w-dee/dotmatrix_64x48_hw_3.0/dotmatrix_64x48.kicad_pcb

## KiCad design dotmatrix_64x48.kicad_pcb (2016-11-04)

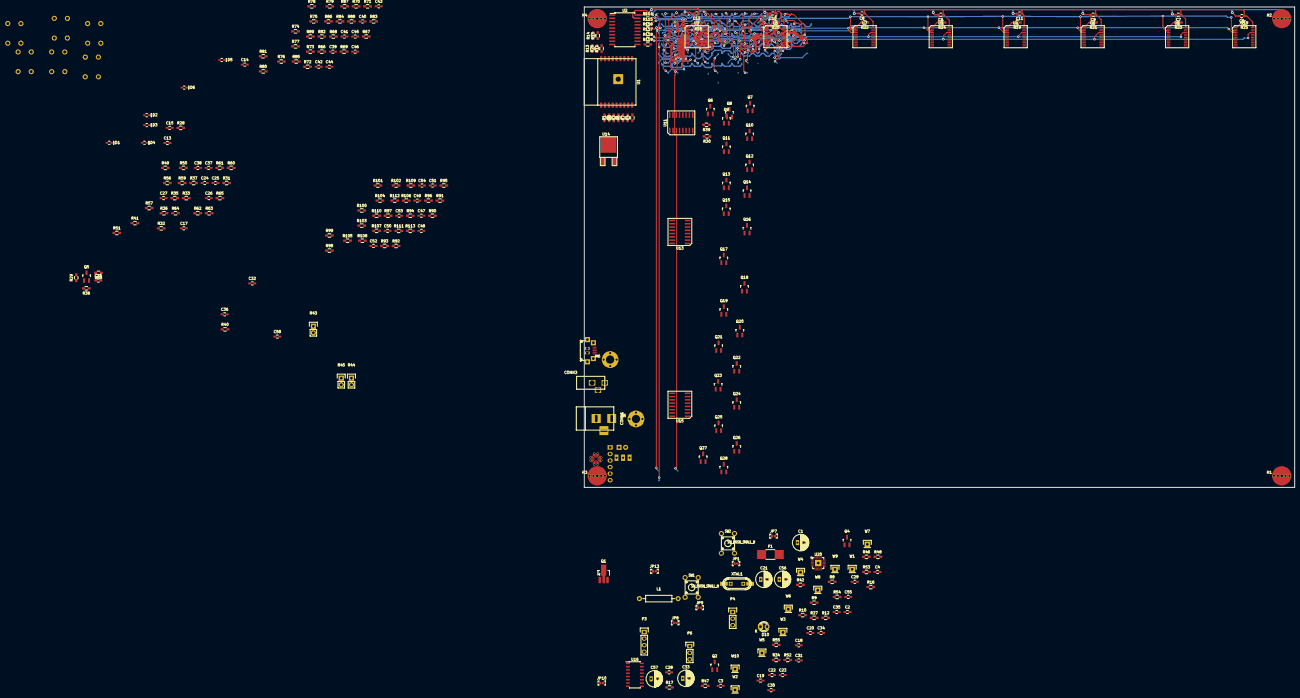
[picture p1: board dotmatrix_64x48.kicad_pcb from above]

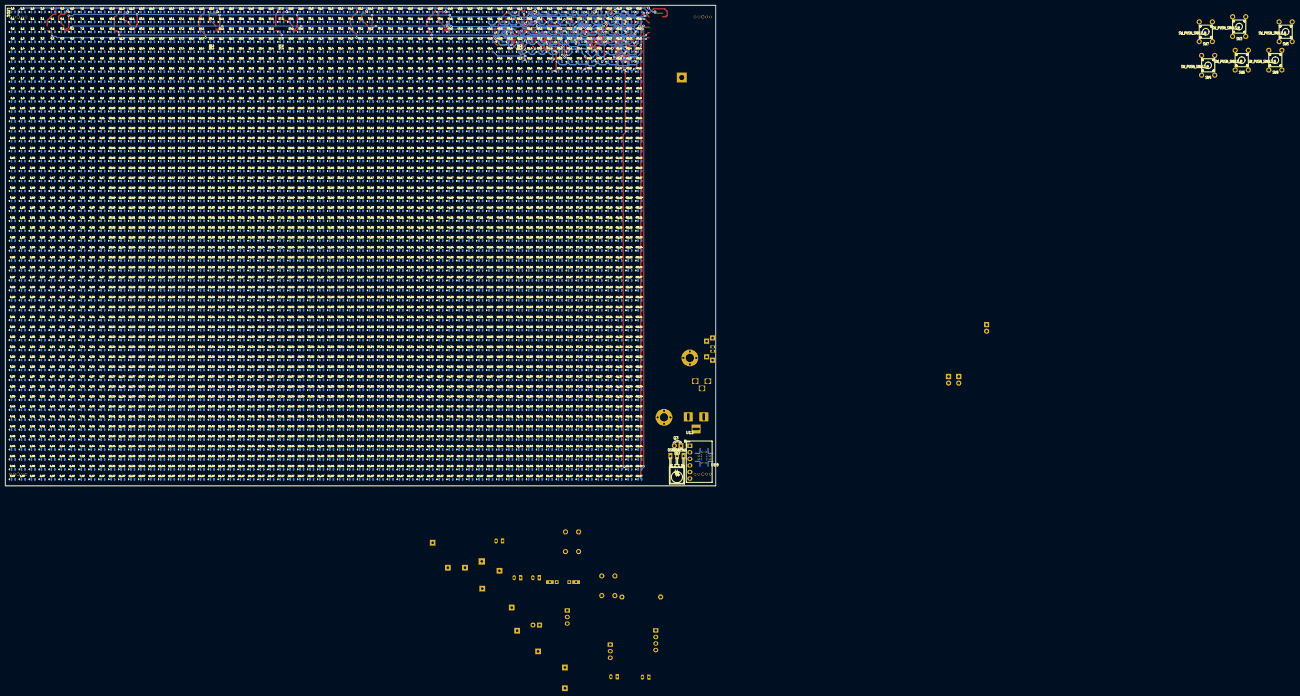
[picture p2: board dotmatrix_64x48.kicad_pcb from below]

Board: 2 copper layers, 275.0 x 186.0 mm, 271 parts (11 on the bottom side), 292 nets.

Parts:
C1, C21, C33, C56, C57: 100u; C_Radial_D6.3_L11.2_P2.5_hand_soldering
C2, C4, C5, C6, C7, C8, C9, C10, C11, C12, C13, C14, C15, C16, C17, C18, C19, C20, C22, C23, C24, C25, C26, C27, C28, C30, C32, C34, C35, C36, C37, C38, C39, C40, C41, C42, C43, C44, C45, C46, C47, C48, C49, C50, C51, C52, C53, C54, C55, C58: 1u; C_0603_HandSoldering
C3: 220p; C_0603_HandSoldering
C29, C31: 22p; C_0603_HandSoldering
CONN1: BARREL_JACK
CONN2: USB_OTG; ZX62R-B-5P
CONN3: BARREL_JACK; DC-JACK-3.5mm
D1, D2, D3, D4, D5, D6: D_Schottky_Small; SOD-523-mod
D10: Led_Small; LED-3MM
F1: FUSE; R_1812_HandSoldering
H1, H2, H3, H4: TEST_1P; MountingHole_stud-M3
H5, H6: TEST_1P; MountingHole_3.2mm_M3
JP1, JP7, JP8, JP9, JP10, JP13: Jumper_NC_Small; SolderJumper
L1: 2.2uH; Resistor_Horizontal_RM15mm
LED1: LED64x48; LED1608_Handsoldering_64x48
P3: CONN_01X04; Pin_Header_Straight_1x04
P4, P6: CONN_01X03; Pin_Header_Straight_1x03
Q1: Q_NPN_BCE RN5006; SOT89-3_Housing_Handsoldering
Q2, Q4: Q_NPN_BEC; SOT-23_Handsoldering
Q3: NJL7302L-F3; LED-3MM
Q5, Q6, Q7, Q8, Q9, Q10, Q11, Q12, Q13, Q14, Q15, Q16, Q17, Q18, Q19, Q20, Q21, Q22, Q23, Q24, Q25, Q26, Q27, Q28: AO3401; SOT-23_Handsoldering
R1, R2, R3, R4, R6, R7, R13, R14, R15, R17, R26, R46, R52, R114, R115, R116, R117, R118, R119: 120R; R_0603_HandSoldering
R5, R11, R18, R28, R34, R53, R54, R55: 10k; R_0603_HandSoldering
R8, R16, R27, R58, R59, R60, R61, R62, R63, R64, R65, R82, R83, R84, R85, R86, R87, R88, R89, R106, R107, R108, R109, R110, R111, R112, R113: 4.7k; R_0603_HandSoldering
R9, R10, R40: 22k; R_0603_HandSoldering
R12, R48: 1k; R_0603_HandSoldering
R19, R20, R21, R22, R23, R24, R25: R; R_0603_HandSoldering
R29, R30, R31, R32, R33, R35, R36, R37, R66, R67, R68, R69, R70, R71, R72, R73, R90, R91, R92, R93, R94, R95, R96, R97: 10R; R_0603_HandSoldering
R38, R39, R41, R49, R50, R51, R56, R57, R74, R75, R76, R77, R78, R79, R80, R81, R98, R99, R100, R101, R102, R103, R104, R105: 4.7k DNI; R_0603_HandSoldering
R42: 10k DNI; R_0603_HandSoldering
R43, R44, R45: 10k; Pin_Header_Straight_1x02
R47: 120R DNI; R_0603_HandSoldering
SW1, SW2, SW3, SW4, SW5, SW6, SW7, SW8: SW_PUSH_SMALL_H; TACT-SW-4P
U1: WROOM-02
U2: 74VHC541; SOIC-20W_7.5x12.8mm_Pitch1.27mm_W
U3, U4, U5, U6, U7, U8, U9, U10: LED1642GW; SOIC-24-0.65mm-w8.0mm
U11, U13, U15: 74HCT595; SOIC-16-1.27mm
U12: AE-BME280
U14: NJU7223; TO-252-2Lead
U16: CH340G; SOIC-16_3.9x9.9mm_Pitch1.27mm
U17: OSRB38C9AA; IRM2161_LAY
U18: BME280; BME280-handsoldering
U20: CP2104; QFN-24-1EP_4x4mm_Pitch0.5mm-handsoldering
W1, W2, W3, W4, W5, W6, W7, W8, W9, W10: TEST_1P; Pin_Header_Straight_1x01
XTAL1: 12MHz; Crystal_HC49-U_Vertical_SMD_Universal

Connections:
/row_driver/SEL1: D1.1, R90.2, U15.7
/row_driver/SEL2: D2.1, R91.2, U15.6
/row_driver/SEL3: D3.1, R92.2, U15.5
/row_driver/SEL4: D4.1, R93.2, U15.4
/row_driver/SEL5: D5.1, R94.2, U15.3
/row_driver/SEL6: D6.1, R95.2, U15.2
/row_driver/f_r0/IN0: R29.2, U11.7
/row_driver/f_r0/IN1: R30.2, U11.6
/row_driver/f_r0/IN2: R31.2, U11.5
/row_driver/f_r0/IN3: R32.2, U11.4
/row_driver/f_r0/IN4: R33.2, U11.3
/row_driver/f_r0/IN5: R35.2, U11.2
/row_driver/f_r0/IN6: R36.2, U11.1
/row_driver/f_r0/IN7: R37.2, U11.15
/row_driver/f_r8/IN0: R66.2, U13.7
/row_driver/f_r8/IN1: R67.2, U13.6
/row_driver/f_r8/IN2: R68.2, U13.5
/row_driver/f_r8/IN3: R69.2, U13.4
/row_driver/f_r8/IN4: R70.2, U13.3
/row_driver/f_r8/IN5: R71.2, U13.2
/row_driver/f_r8/IN6: R72.2, U13.1
/row_driver/f_r8/IN7: R73.2, U13.15
/row_driver/f_r16/IN6: R96.2, U15.1
/row_driver/f_r16/IN7: R97.2, U15.15
BUTTONSENSE: R13.2, R28.2, SW3.2, SW4.2, SW5.2, SW6.2, SW7.2, SW8.2, W9.1
COLCLK: R115.2, U3.3, U4.3, U5.3, U6.3, U7.3, U8.3, U9.3, U10.3, U11.11, U13.11, U15.11, W2.1
COLLATCH: R116.2, U3.4, U4.4, U5.4, U6.4, U7.4, U8.4, U9.4, U10.4, W3.1
COLPWCLK0: R117.2, U3.21, U4.21, U7.21, U8.21, W5.1
COLPWCLK1: R118.2, U5.21, U6.21, U9.21, U10.21, W10.1
COLSER: R114.2, U3.2, W1.1
COLSEROUT: U10.22, U15.14, W4.1
DC_IN: CONN1.1, F1.1, JP7.1
DTR: Q4.2, R54.2, U16.13, U20.23
ESPVDD: C18.1, C19.1, C20.1, C32.1, C33.1, C34.1, C35.1, C36.1, C55.1, C56.1, C57.1, JP8.1, L1.2, R5.2, R8.1, R9.1, R10.1, R11.2, R27.1, R40.1, R45.2, U1.1, U12.1, U17.3, U18.2, U18.6, U18.8
E_AIN: C58.1, Q3.2, R26.2, R43.1
E_COLCLK: R1.1, U2.3
E_COLLATCH: R2.1, U2.4
E_COLSER: R3.1, U2.2
E_HC595LATCH: R6.1, U2.9
E_PWCLK: R14.2, U2.6, U2.7
E_RXD: R14.1, R16.1, U1.11
E_SCL: R4.2, R9.2, R52.1, U1.8
E_SDA: R46.1, U1.14
E_TXD: R17.1, U1.12
GND: C1.2, C4.2, C5.2, C6.2, C7.2, C8.2, C9.2, C10.2, C11.2, C12.2, C13.2, C14.2, C15.2, C16.2, C17.2, C18.2, C19.2, C20.2, C21.2, C22.2, C23.2, C24.2, C25.2, C26.2, C27.2, C28.2, C29.2, C30.2, C31.2, C32.2, C33.2, C34.2, C35.2, C36.2, C37.2, C38.2, C39.2, C40.2, C41.2, C42.2, C43.2, C44.2, C45.2, C46.2, C47.2, C48.2, C49.2, C50.2, C51.2, C52.2, C53.2, C54.2, C55.2, C56.2, C57.2, C58.2, CONN1.2, CONN1.3, CONN2.5, CONN2.6, H1.1, H2.1, H3.1, H4.1, H5.1, H6.1, P3.2, P4.1, P6.1, P6.3, Q1.3, Q3.1, R18.2, R19.2, R20.2, R21.2, R22.2, R23.2, R24.2, R25.2, R34.2, R42.1, R47.1, R47.2, R48.1, R58.1, R59.1, R60.1, R61.1, R62.1, R63.1, R64.1, R65.1, R82.1, R83.1, R84.1, R85.1, R86.1, R87.1, R88.1, R89.1, R106.1, R107.1, R108.1, R109.1, R110.1, R111.1, R112.1, R113.1, SW1.2, SW2.2, U1.9, U1.13, U1.18, U2.1, U2.5, U2.8, U2.10, U2.19, U3.1, U4.1, U5.1, U6.1, U7.1, U8.1, U9.1, U10.1, U11.8, U11.13, U12.2, U13.8, U13.13, U14.3, U15.8, U15.13, U16.1, U17.2, U18.1, U18.5, U18.7, U20.2, U20.25
GPIO0_BTN: Q4.3, R4.1, SW1.1
HC595LATCH: R119.2, U11.12, U13.12, U15.12, W7.1
HC595RESET: U11.10, U13.10, U15.10, W6.1
HC595SEROUT: U11.9, W8.1
IR_IN: R15.2, R40.2, U17.1
IR_OUT: C2.2, D10.2, R7.1
LEDLOGICVDD: C5.1, C6.1, C7.1, C8.1, C9.1, C10.1, C11.1, C12.1, JP13.2, L1.1, P6.2, R28.1, U2.20, U3.24, U4.24, U5.24, U6.24, U7.24, U8.24, U9.24, U10.24
LEDVDD: C13.1, C14.1, C15.1, C16.1, C17.1, C24.1, C25.1, C26.1, C27.1, C37.1, C38.1, C39.1, C40.1, C41.1, C42.1, C43.1, C44.1, C45.1, C46.1, C47.1, C48.1, C49.1, C50.1, C51.1, C52.1, C53.1, C54.1, JP1.2, Q5.2, Q6.2, Q7.2, Q8.2, Q9.2, Q10.2, Q11.2, Q12.2, Q13.2, Q14.2, Q15.2, Q16.2, Q17.2, Q18.2, Q19.2, Q20.2, Q21.2, Q22.2, Q23.2, Q24.2, Q25.2, Q26.2, Q27.2, Q28.2, R38.1, R39.1, R41.1, R49.1, R50.1, R51.1, R56.1, R57.1, R74.1, R75.1, R76.1, R77.1, R78.1, R79.1, R80.1, R81.1, R98.1, R99.1, R100.1, R101.1, R102.1, R103.1, R104.1, R105.1, U11.16, U13.16, U15.16
unnamed: C1.1, C23.1, JP13.1, U14.1
unnamed: C2.1, C3.2, R12.1
unnamed: C3.1, Q1.1, R12.2, R42.2
unnamed: C28.1, C30.1, JP8.2, R53.1, U16.4, U16.16, U20.5, U20.6, U20.7
unnamed: C29.1, U16.7, XTAL1.1
unnamed: C31.1, U16.8, XTAL1.2
unnamed: CONN2.1, JP7.2
unnamed: CONN3.2, CONN3.3, Q1.2
unnamed: D1.2, SW3.1
unnamed: D2.2, SW4.1
unnamed: D3.2, SW5.1
unnamed: D4.2, SW6.1
unnamed: D5.2, SW7.1
unnamed: D6.2, SW8.1
unnamed: D10.1, R48.2
unnamed: JP9.1, U16.2, U20.21
unnamed: JP10.1, U16.3, U20.20
unnamed: Q2.1, R54.1
unnamed: Q4.1, R55.1
unnamed: Q5.1, R29.1, R38.2
unnamed: Q6.1, R30.1, R39.2
unnamed: Q7.1, R31.1, R41.2
unnamed: Q8.1, R32.1, R49.2
unnamed: Q9.1, R33.1, R50.2
unnamed: Q10.1, R35.1, R51.2
unnamed: Q11.1, R36.1, R56.2
unnamed: Q12.1, R37.1, R57.2
unnamed: Q13.1, R66.1, R74.2
unnamed: Q14.1, R67.1, R75.2
unnamed: Q15.1, R68.1, R76.2
unnamed: Q16.1, R69.1, R77.2
unnamed: Q17.1, R70.1, R78.2
unnamed: Q18.1, R71.1, R79.2
unnamed: Q19.1, R72.1, R80.2
unnamed: Q20.1, R73.1, R81.2
unnamed: Q21.1, R90.1, R98.2
unnamed: Q22.1, R91.1, R99.2
unnamed: Q23.1, R92.1, R100.2
unnamed: Q24.1, R93.1, R101.2
unnamed: Q25.1, R94.1, R102.2
unnamed: Q26.1, R95.1, R103.2
unnamed: Q27.1, R96.1, R104.2
unnamed: Q28.1, R97.1, R105.2
unnamed: R1.2, U1.3
unnamed: R2.2, U1.4
unnamed: R3.2, U1.5
unnamed: R5.1, U1.2
unnamed: R7.2, R10.2, U1.7
unnamed: R13.1, U1.17
unnamed: R15.1, U1.10
unnamed: R18.1, U3.23
unnamed: R19.1, U4.23
unnamed: R20.1, U5.23
unnamed: R21.1, U6.23
unnamed: R22.1, U7.23
unnamed: R23.1, U8.23
unnamed: R24.1, U9.23
unnamed: R25.1, U10.23
unnamed: R26.1, U1.16
unnamed: R6.2, R34.1, U1.6
unnamed: R43.2, R44.1
unnamed: R44.2, R45.1
unnamed: R53.2, U20.9
unnamed: R114.1, U2.18
unnamed: R115.1, U2.17
unnamed: R116.1, U2.16
unnamed: R117.1, U2.14
unnamed: R118.1, U2.13
unnamed: R119.1, U2.11
unnamed: U3.22, U5.2
unnamed: U4.2, U9.22
unnamed: U4.22, U6.2
unnamed: U5.22, U7.2
unnamed: U6.22, U8.2
unnamed: U7.22, U9.2
unnamed: U8.22, U10.2
unnamed: U11.14, U13.9
unnamed: U13.14, U15.9
RST: Q2.3, R11.1, SW2.1, U1.15
RTS: Q2.2, R55.2, U16.14, U20.19
RXD: JP9.2, P3.3, R16.2
SCL: P4.2, R8.2, R52.2, U12.6, U18.4
SDA: P4.3, R27.2, R46.2, U12.4, U18.3
TXD: JP10.2, P3.4, R17.2
USB_D_N: CONN2.2, U16.6, U20.4
USB_D_P: CONN2.3, U16.5, U20.3
VCC: C4.1, C21.1, C22.1, CONN3.1, F1.2, JP1.1, U14.2, U20.8
ce0: LED1.1, U10.20
ce1: LED1.2, U10.18
ce2: LED1.3, U10.16
ce3: LED1.4, U10.14
ce4: LED1.5, U10.12
ce5: LED1.6, U10.10
ce6: LED1.7, U10.8
ce7: LED1.8, U10.6
ce8: LED1.9, U8.20
ce9: LED1.10, U8.18
ce10: LED1.11, U8.16
ce11: LED1.12, U8.14
ce12: LED1.13, U8.12
ce13: LED1.14, U8.10
ce14: LED1.15, U8.8
ce15: LED1.16, U8.6
ce16: LED1.17, U6.20
ce17: LED1.18, U6.18
ce18: LED1.19, U6.16
ce19: LED1.20, U6.14
ce20: LED1.21, U6.12
ce21: LED1.22, U6.10
ce22: LED1.23, U6.8
ce23: LED1.24, U6.6
ce24: LED1.25, U4.20
ce25: LED1.26, U4.18
ce26: LED1.27, U4.16
ce27: LED1.28, U4.14
ce28: LED1.29, U4.12
ce29: LED1.30, U4.10
ce30: LED1.31, U4.8
ce31: LED1.32, U4.6
ce32: LED1.33, U9.20
ce33: LED1.34, U9.18
ce34: LED1.35, U9.16
ce35: LED1.36, U9.14
ce36: LED1.37, U9.12
ce37: LED1.38, U9.10
ce38: LED1.39, U9.8
ce39: LED1.40, U9.6
ce40: LED1.41, U7.20
ce41: LED1.42, U7.18
ce42: LED1.43, U7.16
ce43: LED1.44, U7.14
ce44: LED1.45, U7.12
ce45: LED1.46, U7.10
ce46: LED1.47, U7.8
ce47: LED1.48, U7.6
ce48: LED1.49, U5.20
ce49: LED1.50, U5.18
ce50: LED1.51, U5.16
ce51: LED1.52, U5.14
ce52: LED1.53, U5.12
ce53: LED1.54, U5.10
ce54: LED1.55, U5.8
ce55: LED1.56, U5.6
ce56: LED1.57, U3.20
ce57: LED1.58, U3.18
ce58: LED1.59, U3.16
ce59: LED1.60, U3.14
ce60: LED1.61, U3.12
ce61: LED1.62, U3.10
ce62: LED1.63, U3.8
ce63: LED1.64, U3.6
co0: LED1.65, U10.19
co1: LED1.66, U10.17
co2: LED1.67, U10.15
co3: LED1.68, U10.13
co4: LED1.69, U10.11
co5: LED1.70, U10.9
co6: LED1.71, U10.7
co7: LED1.72, U10.5
co8: LED1.73, U8.19
co9: LED1.74, U8.17
co10: LED1.75, U8.15
co11: LED1.76, U8.13
co12: LED1.77, U8.11
co13: LED1.78, U8.9
co14: LED1.79, U8.7
co15: LED1.80, U8.5
co16: LED1.81, U6.19
co17: LED1.82, U6.17
co18: LED1.83, U6.15
co19: LED1.84, U6.13
co20: LED1.85, U6.11
co21: LED1.86, U6.9
co22: LED1.87, U6.7
co23: LED1.88, U6.5
co24: LED1.89, U4.19
co25: LED1.90, U4.17
co26: LED1.91, U4.15
co27: LED1.92, U4.13
co28: LED1.93, U4.11
co29: LED1.94, U4.9
co30: LED1.95, U4.7
co31: LED1.96, U4.5
co32: LED1.97, U9.19
co33: LED1.98, U9.17
co34: LED1.99, U9.15
co35: LED1.100, U9.13
co36: LED1.101, U9.11
co37: LED1.102, U9.9
co38: LED1.103, U9.7
co39: LED1.104, U9.5
co40: LED1.105, U7.19
co41: LED1.106, U7.17
co42: LED1.107, U7.15
co43: LED1.108, U7.13
co44: LED1.109, U7.11
co45: LED1.110, U7.9
co46: LED1.111, U7.7
co47: LED1.112, U7.5
co48: LED1.113, U5.19
co49: LED1.114, U5.17
co50: LED1.115, U5.15
co51: LED1.116, U5.13
co52: LED1.117, U5.11
co53: LED1.118, U5.9
co54: LED1.119, U5.7
co55: LED1.120, U5.5
co56: LED1.121, U3.19
co57: LED1.122, U3.17
co58: LED1.123, U3.15
co59: LED1.124, U3.13
co60: LED1.125, U3.11
co61: LED1.126, U3.9
co62: LED1.127, U3.7
co63: LED1.128, U3.5
r0: LED1.201, Q5.3, R58.2
r1: LED1.202, Q6.3, R59.2
r2: LED1.203, Q7.3, R60.2
r3: LED1.204, Q8.3, R61.2
r4: LED1.205, Q9.3, R62.2
r5: LED1.206, Q10.3, R63.2
r6: LED1.207, Q11.3, R64.2
r7: LED1.208, Q12.3, R65.2
r8: LED1.209, Q13.3, R82.2
r9: LED1.210, Q14.3, R83.2
r10: LED1.211, Q15.3, R84.2
r11: LED1.212, Q16.3, R85.2
r12: LED1.213, Q17.3, R86.2
r13: LED1.214, Q18.3, R87.2
r14: LED1.215, Q19.3, R88.2
r15: LED1.216, Q20.3, R89.2
r16: LED1.217, Q21.3, R106.2
r17: LED1.218, Q22.3, R107.2
r18: LED1.219, Q23.3, R108.2
r19: LED1.220, Q24.3, R109.2
r20: LED1.221, Q25.3, R110.2
r21: LED1.222, Q26.3, R111.2
r22: LED1.223, Q27.3, R112.2
r23: LED1.224, Q28.3, R113.2
