w-dee/dotmatrix_64x48_hw_3.0/(commit log)

2016-10-04 Modified directory structure
    [IR_Sensor_RTC.sch, dotmatrix_64x24.kicad_pcb, dotmatrix_64x24.sch, file57A04605.sch, ledmatrix.sch]
2016-11-01 Schematic sheet rearrangement
    [IR_Sensor_RTC.sch, column_driver.sch, dotmatrix_64x24.sch, fet-driver.sch, file57A04605.sch, ledmatrix.sch, row_driver.sch]
2016-11-04 Rename; Large preparation for 64x48 dot matrix clock
    [IR_Sensor.sch, IR_Sensor_RTC.sch, column_driver.sch, dotmatrix_64x24.kicad_pcb, dotmatrix_64x48.kicad_pcb, dotmatrix_64x48.sch, fet-driver.sch, file57A04605.sch]
2016-11-10 Done connecting LED driver
    [IR_Sensor.sch, column_driver.sch, dotmatrix_64x48.sch, fet-driver.sch, row_driver.sch]
2016-11-10 Done overall component arrangement
    [IR_Sensor.sch, column_driver.sch, dotmatrix_64x48.sch, fet-driver.sch, row_driver.sch]
2016-11-14 Done rough layout
    [IR_Sensor.sch, column_driver.sch, dotmatrix_64x48.sch, fet-driver.sch, row_driver.sch]
2016-11-15 Silk fix; Various fixes
    [dotmatrix_64x48.sch]
2016-11-15 Added led alignment ruler
2016-11-16 fixed holes under pad
2016-11-17 Bypass capacitor improvements, various adjustments
    [IR_Sensor.sch, column_driver.sch, dotmatrix_64x48.sch, fet-driver.sch, row_driver.sch]
2016-11-18 Various improvements
    [IR_Sensor.sch, column_driver.sch, dotmatrix_64x48.sch, fet-driver.sch, ledmatrix.sch, row_driver.sch]
2016-11-19 Modified some components' foot print
    [IR_Sensor.sch, column_driver.sch, dotmatrix_64x48.sch, fet-driver.sch, ledmatrix.sch, row_driver.sch]
2016-11-21 Changed USB-UART chip from CH340G to CP2104
    [IR_Sensor.sch, column_driver.sch, dotmatrix_64x48.sch, fet-driver.sch, ledmatrix.sch, row_driver.sch]
2016-11-22 Added some status LEDs; Various improvements
    [IR_Sensor.sch, column_driver.sch, dotmatrix_64x48.sch, fet-driver.sch, row_driver.sch]
2016-11-23 Rearrange buttons and more
2016-11-25 Noise handling improved
    [IR_Sensor.sch, column_driver.sch, dotmatrix_64x48.sch, fet-driver.sch, row_driver.sch]
2016-11-26 Modified USB connector footprints and more
    [IR_Sensor.sch, column_driver.sch, dotmatrix_64x48.sch, fet-driver.sch, ledmatrix.sch, row_driver.sch]
2016-11-29 Improved noise handling
    [IR_Sensor.sch, column_driver.sch, dotmatrix_64x48.sch, fet-driver.sch, ledmatrix.sch, row_driver.sch]
2016-11-30 Make PCB corner round; Arranged DC input network
    [IR_Sensor.sch, column_driver.sch, dotmatrix_64x48.sch, fet-driver.sch, row_driver.sch]
2016-12-01 Fixed noisy signal path
    [IR_Sensor.sch, column_driver.sch, dotmatrix_64x48.sch, fet-driver.sch, row_driver.sch]
2016-12-02 Fixed tact-sw footprint; Removed PCB area under anttena
    [dotmatrix_64x48.sch]
2016-12-03 Relocated traces of noise sensitive
2016-12-03 Fixed resistor position
2016-12-08 To be able to disconnect noisy RXD line
    [IR_Sensor.sch, column_driver.sch, dotmatrix_64x48.sch, fet-driver.sch, row_driver.sch]
2016-12-10 Improved LED drive current filter
    [IR_Sensor.sch, column_driver.sch, dotmatrix_64x48.sch, fet-driver.sch, ledmatrix.sch, row_driver.sch]
2016-12-12 Made USB-UART bridge dettachable
    [IR_Sensor.sch, column_driver.sch, dotmatrix_64x48.sch, fet-driver.sch, ledmatrix.sch, row_driver.sch, usb_uart.sch]
2016-12-13 To be able to get diagnostic result from LED driver
    [dotmatrix_64x48.sch]
2016-12-14 Small fixes; should be very close to final design of rev.2
    [dotmatrix_64x48.sch]
2016-12-16 Gerber-out, revision 2
    [dotmatrix_64x48.gbl, dotmatrix_64x48.gbs, dotmatrix_64x48.gm1, dotmatrix_64x48.gtl, dotmatrix_64x48.gts]
2016-12-19 Commit toward rev2.1. loosen slot width to compat with other PCB manufacturres
2016-12-21 Improved ESD handling
    [IR_Sensor.sch, column_driver.sch, dotmatrix_64x48.sch, fet-driver.sch, row_driver.sch, usb_uart.sch]
2016-12-28 Component size and position improvements
    [IR_Sensor.sch, dotmatrix_64x48.sch]
2017-02-07 Varous improvements including adjusting SOIC pad width, increasing CP2104 bypass cap ... etc
    [IR_Sensor.sch, column_driver.sch, dotmatrix_64x48.sch, fet-driver.sch, row_driver.sch, usb_uart.sch]
2017-02-18 Update to newest kicad's library; Fixing USB-to-serial drive strength problems (Silks and pattern tuning not yet done)
    [IR_Sensor.sch, column_driver.sch, dotmatrix_64x48.sch, fet-driver.sch, ledmatrix.sch, row_driver.sch, usb_uart.sch]
2017-03-01 Weak signal separation
    [column_driver.sch, dotmatrix_64x48.sch, fet-driver.sch, row_driver.sch]
2017-03-16 Re-layout LED drivers to reduce EMI
    [fet-driver.sch, row_driver.sch]
2017-03-20 Layout adjustments toward proto rev.3
    [column_driver.sch]
2017-03-23 Added long transmission line terminator; DRC clear
    [IR_Sensor.sch, column_driver.sch, dotmatrix_64x48.sch, fet-driver.sch, row_driver.sch]
2017-03-28 Added more guard traces; DRC may not clear
2017-03-31 Improved weak signal guards; Added WROOM-02 socket pattern; Improved USB-UART power filtering
    [usb_uart.sch]
2017-04-01 Layout improvements; Should be close to Gerber out
2017-04-04 Separated GND and GNDPWR; Filled matrix with copper; DRC clear (2 errors expected)
    [IR_Sensor.sch, column_driver.sch, dotmatrix_64x48.sch, fet-driver.sch, row_driver.sch]
2017-04-09 Various adjustments; Very very close to Prototype Rev.3 Gerber out
2017-04-09 Some improvements; Still close to the Gerber out
2017-04-11 Gerber out, prototype rev.3
    [dotmatrix_64x48.gbs, dotmatrix_64x48.gm1, dotmatrix_64x48.gtl, dotmatrix_64x48.gts]
2017-06-14 Hardware design update toward final release
    [column_driver.sch, fet-driver.sch, row_driver.sch]
2017-06-24 Fixed ambient light sensor voltage range; and more
    [IR_Sensor.sch, column_driver.sch, dotmatrix_64x48.sch, fet-driver.sch, ledmatrix.sch, row_driver.sch, usb_uart.sch]
2017-06-26 Modified USBGND->GND; Layout improvement for edge skrew hole
    [IR_Sensor.sch, column_driver.sch, dotmatrix_64x48.sch, fet-driver.sch, row_driver.sch, usb_uart.sch]
2017-06-28 Improved grounding
2017-06-28 Check overlap of pads and holes; DRC clear
2017-06-29 Compreted cross-GND vias
2017-06-30 GND pattern improved; Should be just before gerber out
2017-07-05 PCB production rev.1
    [dotmatrix_64x48-B.Mask.gbs, dotmatrix_64x48-Edge.Cuts.gm1, dotmatrix_64x48-F.Cu.gtl, dotmatrix_64x48-F.Mask.gts, dotmatrix_64x48-F.SilkS.gto, dotmatrix_64x48-NPTH.drl, dotmatrix_64x48-PTH.drl, dotmatrix_64x48.gbs]
2017-07-22 To use push-terminal-block for IR LED; About to use diferrencial clocking for LED PWM clock to reduce EMI
    [IR_Sensor.sch, column_driver.sch, dotmatrix_64x48.sch, fet-driver.sch, row_driver.sch]
2017-09-01 Schematic structure rearranged
    [IR_Sensor.sch, column_driver.sch, dotmatrix_64x48.sch, fet-driver.sch, ledmatrix.sch, power.sch, row_driver.sch, signal_driver.sch]
